atx/avr-mqtt-board/README.md

avr-mqtt-board
==============

Board with AVR and Ethernet supporting MQTT
