atx/avr-mqtt-board/enclosure.dxf

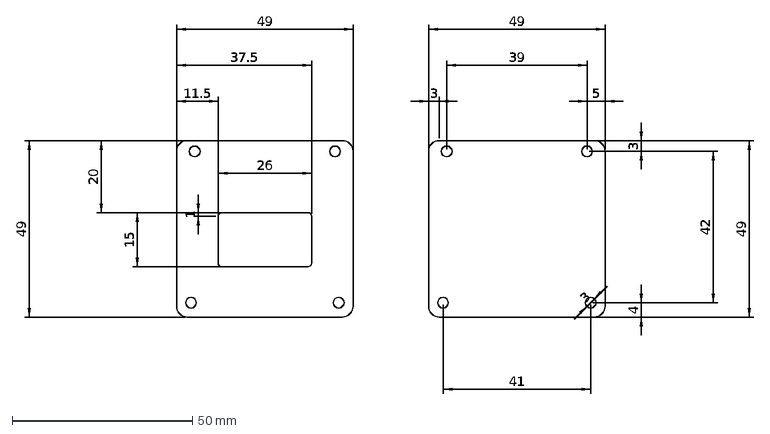
[picture p1: CAD file, 2014-08-16]
enclosure.dxf
39
49
3
5
4
42
41
37.5
11.5
26
15
1
20
