atx/avr-mqtt-board/pcb/avr-sensors.pdf

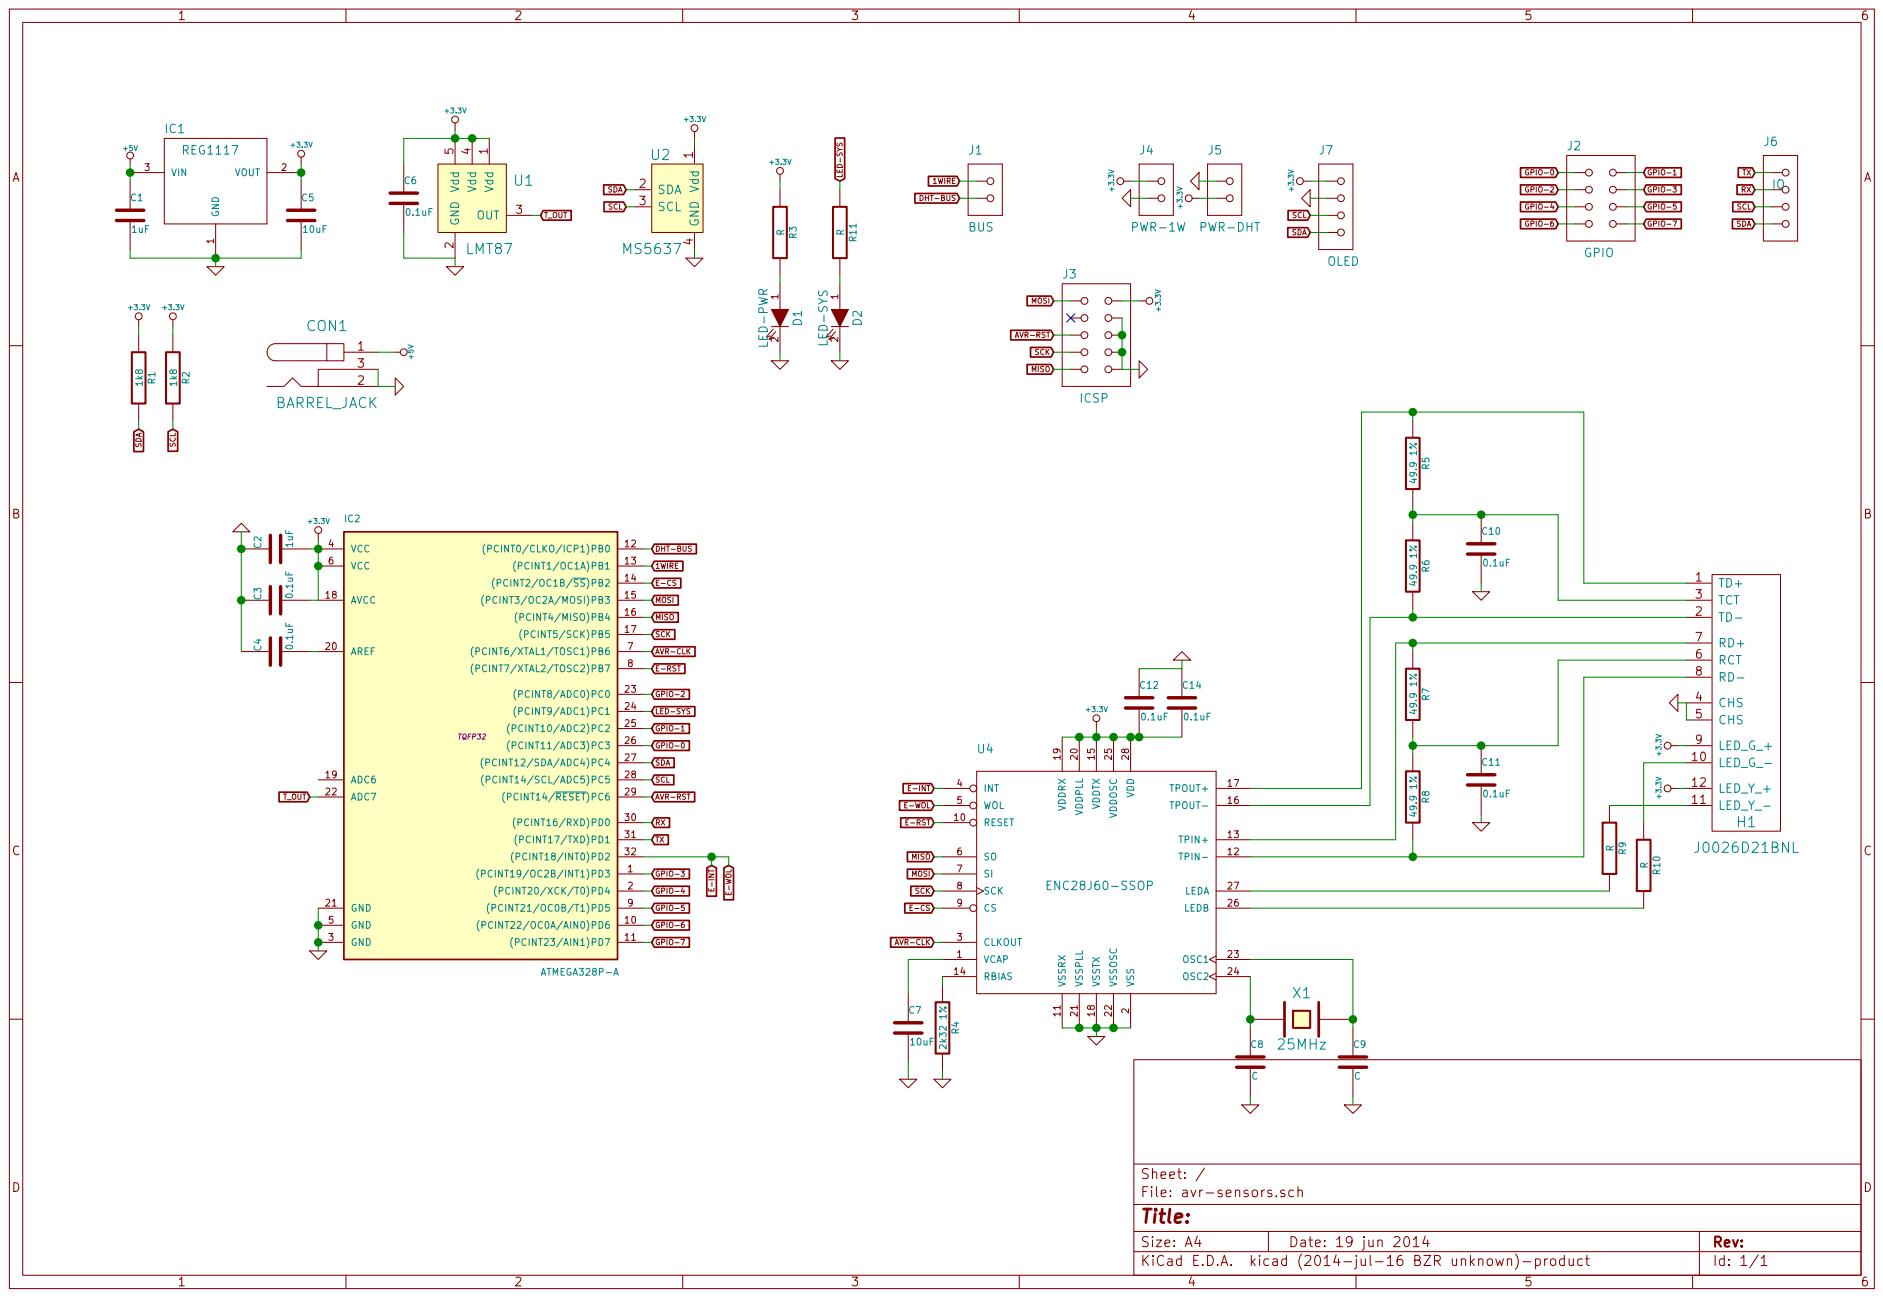
[picture p2: page 1]

E-INT E-WOL MISO MOSI SCK

+3.3V GPIO-2 GPIO-3 GPIO-4 GPIO-5 GPIO-6 GPIO-7

Id: 1/1 Title: File: avr-sensors.sch Sheet: /
