atx/avr-mqtt-board/pcb/avr-sensors.kicad_pcb

## KiCad design pcb/avr-sensors.kicad_pcb (2014-08-08)

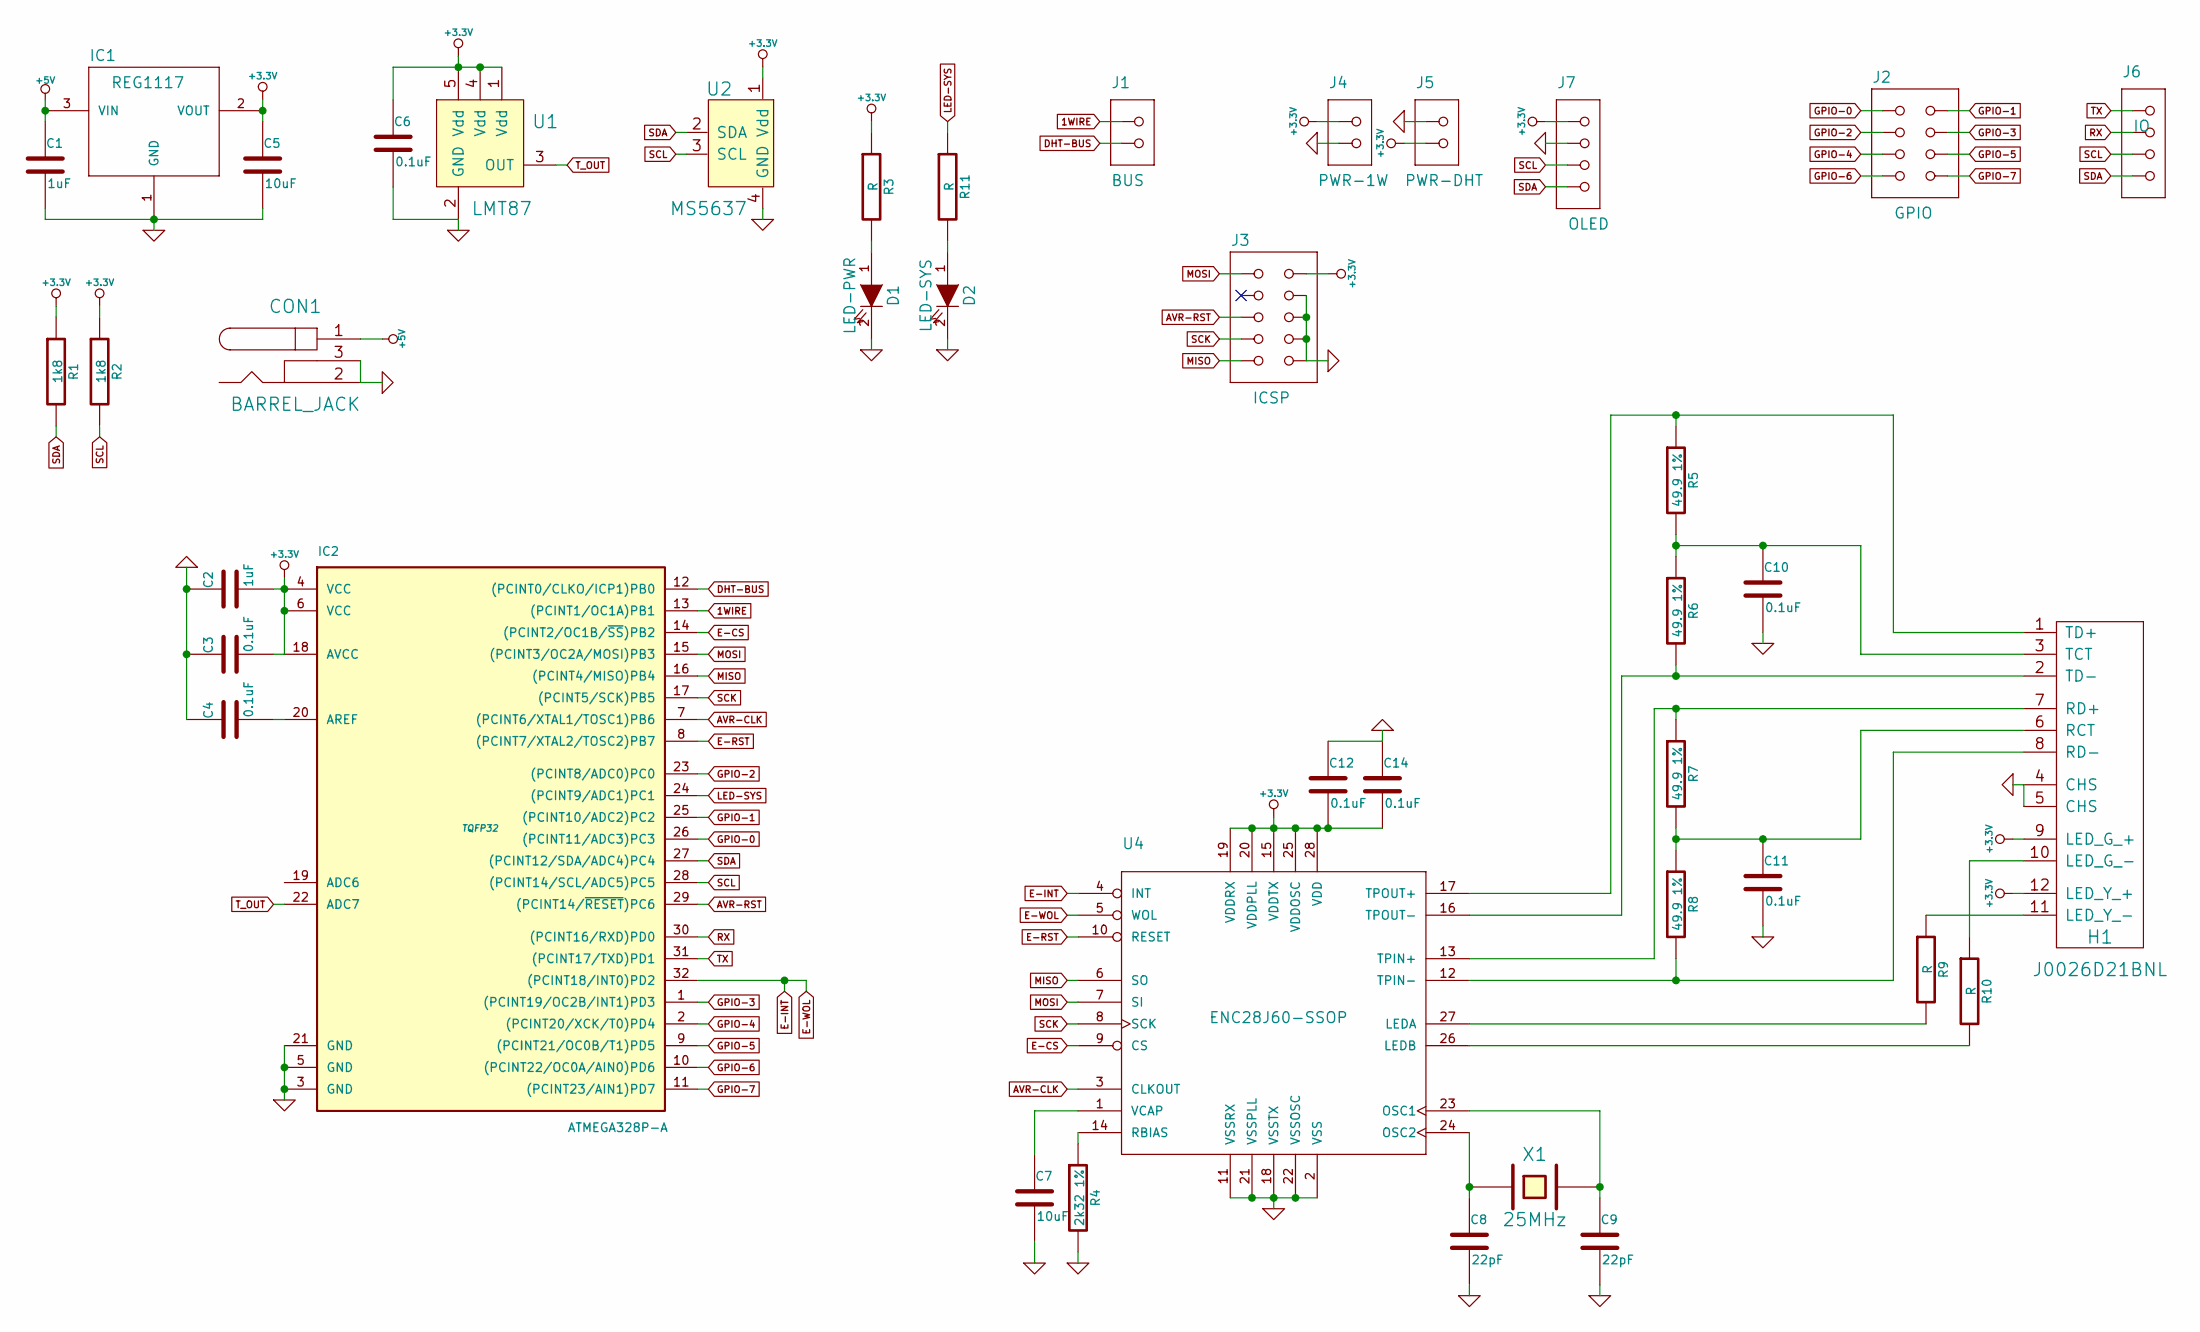
[picture p3: schematic avr-sensors.sch]

Parts:
C1, C2: 1uF
C3, C4, C6, C10, C11, C12, C14: 0.1uF
C5, C7: 10uF
C8, C9: 22pF
CON1: BARREL_JACK
D1: LED-PWR
D2: LED-SYS
H1: J0026D21BNL
IC1: REG1117; burr-brown-3-SOT223
IC2: ATMEGA328P-A; TQFP32
J1: BUS; dp_devices-TERMINAL_BLOCK_2P_5
J2: GPIO; dp_devices-M2X4
J3: ICSP; dp_devices-M2X5
J4: PWR-1W; dp_devices-TERMINAL_BLOCK_2P_5
J5: PWR-DHT; dp_devices-TERMINAL_BLOCK_2P_5
J6: IO; dp_devices-M1X4
J7: OLED; dp_devices-M1X4
R1, R2: 1k8
R3, R9, R10, R11: R
R4: 2k32 1%
R5, R6, R7, R8: 49.9 1%
U1: LMT87
U2: MS5637
U4: ENC28J60-SSOP; microchip-enc28j60-SSOP28
X1: 25MHz

Connections:
1WIRE: IC2.13 ((PCINT1/OC1A)PB1), J1.1
+3.3V: C2.2, C3.2, C5.1, C6.1, C12.2, C14.2, H1.9 (LED_G_+), H1.12 (LED_Y_+), IC1.2 (VOUT), IC2.4 (VCC), IC2.6 (VCC), IC2.18 (AVCC), J3.2, J4.1, J5.2, J7.1, R1.1, R2.1, R3.1, U1.1 (Vdd), U1.4 (Vdd), U1.5 (Vdd), U2.1 (Vdd), U4.15 (VDDTX), U4.19 (VDDRX), U4.20 (VDDPLL), U4.25 (VDDOSC), U4.28 (VDD)
+5V: C1.1, CON1.1, IC1.3 (VIN)
AVR-CLK: IC2.7 ((PCINT6/XTAL1/TOSC1)PB6), U4.3 (CLKOUT)
AVR-RST: IC2.29 ((PCINT14/~RESET~)PC6), J3.5
DHT-BUS: IC2.12 ((PCINT0/CLKO/ICP1)PB0), J1.2
E-CS: IC2.14 ((PCINT2/OC1B/~SS~)PB2), U4.9 (CS)
E-INT: IC2.32 ((PCINT18/INT0)PD2), U4.4 (INT), U4.5 (WOL)
E-RST: IC2.8 ((PCINT7/XTAL2/TOSC2)PB7), U4.10 (RESET)
GND: C1.2, C2.1, C3.1, C4.1, C5.2, C6.2, C7.2, C8.2, C9.2, C10.2, C11.2, C12.1, C14.1, CON1.2, CON1.3, D1.2 (K), D2.2 (K), H1.4 (CHS), H1.5 (CHS), IC1.1 (GND), IC2.3 (GND), IC2.5 (GND), IC2.21 (GND), J3.4, J3.6, J3.8, J3.10, J4.2, J5.1, J7.2, R4.2, U1.2 (GND), U2.4 (GND), U4.2 (VSS), U4.11 (VSSRX), U4.18 (VSSTX), U4.21 (VSSPLL), U4.22 (VSSOSC)
GPIO-0: IC2.26 ((PCINT11/ADC3)PC3), J2.1
GPIO-1: IC2.25 ((PCINT10/ADC2)PC2), J2.2
GPIO-2: IC2.23 ((PCINT8/ADC0)PC0), J2.3
GPIO-3: IC2.1 ((PCINT19/OC2B/INT1)PD3), J2.4
GPIO-4: IC2.2 ((PCINT20/XCK/T0)PD4), J2.5
GPIO-5: IC2.9 ((PCINT21/OC0B/T1)PD5), J2.6
GPIO-6: IC2.10 ((PCINT22/OC0A/AIN0)PD6), J2.7
GPIO-7: IC2.11 ((PCINT23/AIN1)PD7), J2.8
LED-SYS: IC2.24 ((PCINT9/ADC1)PC1), R11.1
MISO: IC2.16 ((PCINT4/MISO)PB4), J3.9, U4.6 (SO)
MOSI: IC2.15 ((PCINT3/OC2A/MOSI)PB3), J3.1, U4.7 (SI)
unnamed: C4.2, IC2.20 (AREF)
unnamed: C7.1, U4.1 (VCAP)
unnamed: C8.1, U4.24 (OSC2), X1.1
unnamed: C9.1, U4.23 (OSC1), X1.2
unnamed: C10.1, H1.3 (TCT), R5.2, R6.1
unnamed: C11.1, H1.6 (RCT), R7.2, R8.1
unnamed: D1.1 (A), R3.2
unnamed: D2.1 (A), R11.2
unnamed: H1.1 (TD+), R5.1, U4.17 (TPOUT+)
unnamed: H1.2 (TD-), R6.2, U4.16 (TPOUT-)
unnamed: H1.7 (RD+), R7.1, U4.13 (TPIN+)
unnamed: H1.8 (RD-), R8.2, U4.12 (TPIN-)
unnamed: H1.10 (LED_G_-), R10.1
unnamed: H1.11 (LED_Y_-), R9.1
unnamed: R4.1, U4.14 (RBIAS)
unnamed: R9.2, U4.27 (LEDA)
unnamed: R10.2, U4.26 (LEDB)
RX: IC2.30 ((PCINT16/RXD)PD0), J6.2
SCK: IC2.17 ((PCINT5/SCK)PB5), J3.7, U4.8 (SCK)
SCL: IC2.28 ((PCINT14/SCL/ADC5)PC5), J6.3, J7.3, R2.2, U2.3 (SCL)
SDA: IC2.27 ((PCINT12/SDA/ADC4)PC4), J6.4, J7.4, R1.2, U2.2 (SDA)
TX: IC2.31 ((PCINT17/TXD)PD1), J6.1
T_OUT: IC2.22 (ADC7), U1.3 (OUT)

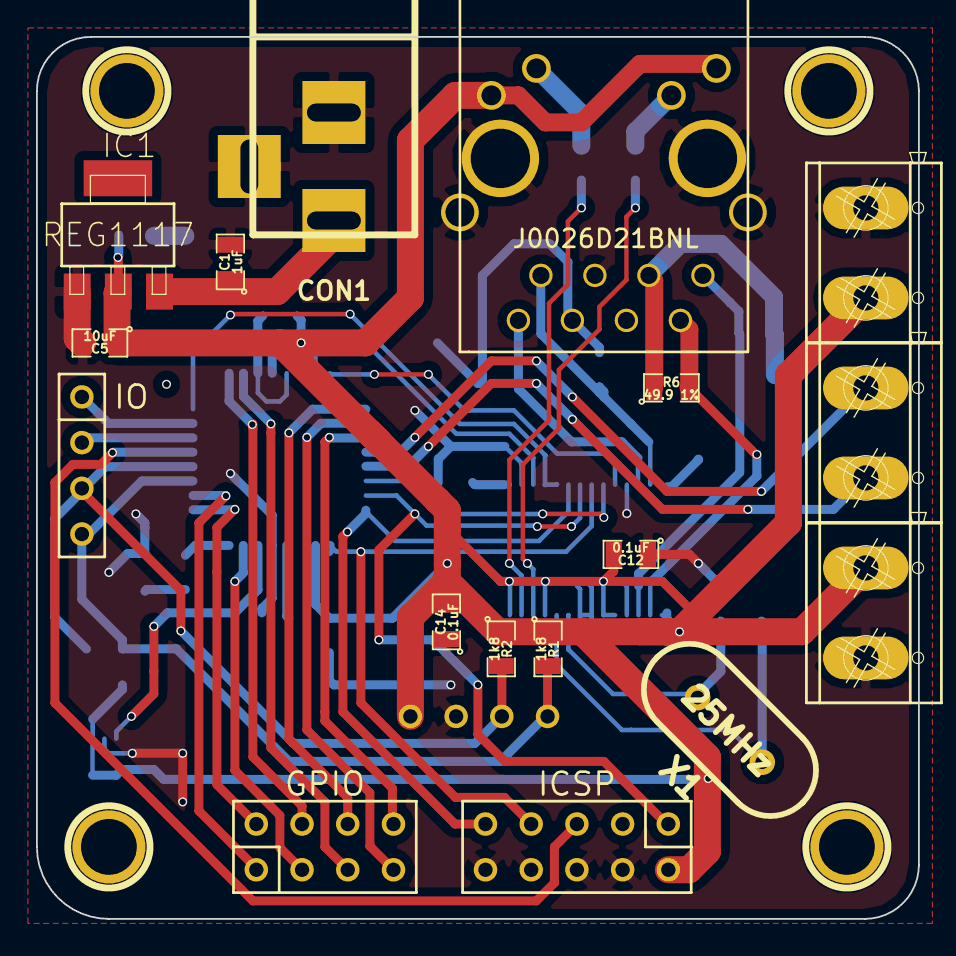
[picture p4: board avr-sensors.kicad_pcb from above]

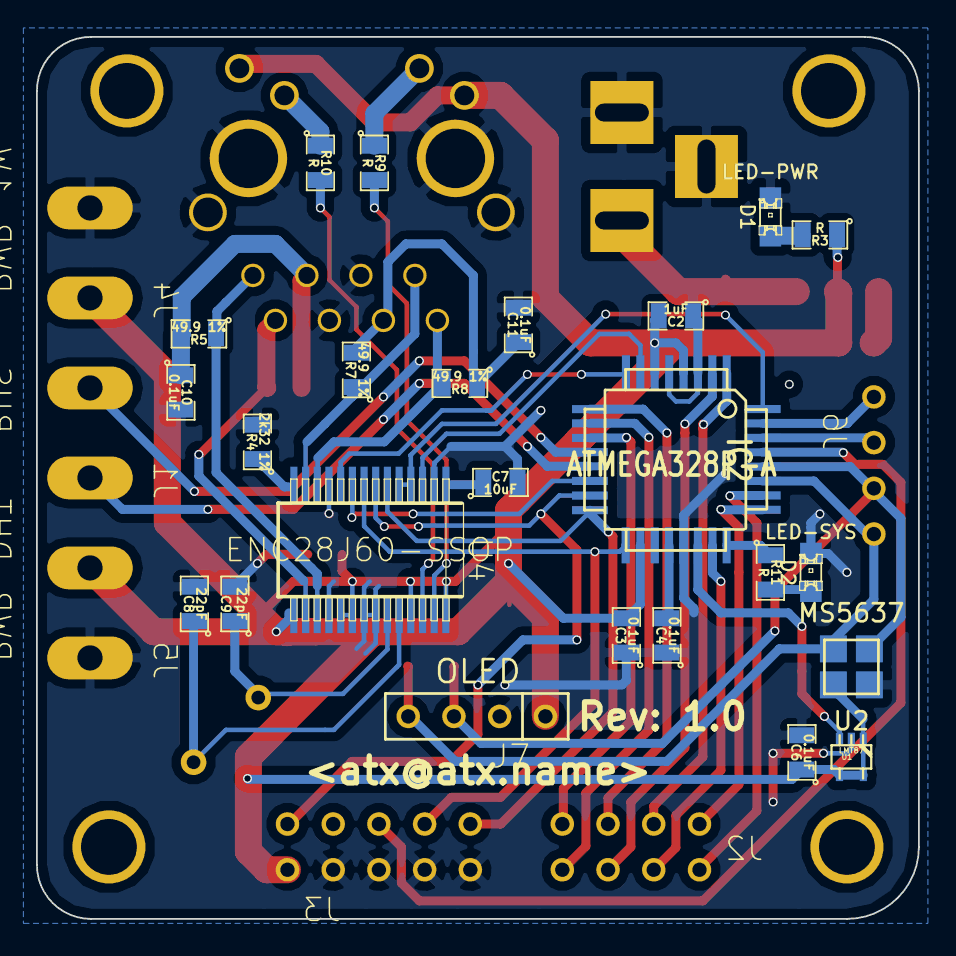
[picture p5: board avr-sensors.kicad_pcb from below]

Board: 2 copper layers, 49.0 x 49.0 mm, 41 parts (24 on the bottom side), 44 nets.
