atx/avr-mqtt-board/src/bitmaps.h

#include <avr/pgmspace.h>

const uint8_t PROGMEM bitmaps_7seg7x16[][14] = {
	{
		0xf0, 0xf0, 0x30, 0x30, 0x30, 0xf0, 0xf0,
		0xff, 0xff, 0xc0, 0xc0, 0xc0, 0xff, 0xff,
	},
	{
		0x00, 0x00, 0x00, 0x00, 0x00, 0xf0, 0xf0,
		0x00, 0x00, 0x00, 0x00, 0x00, 0xff, 0xff,
	},
	{
		0x30, 0x30, 0x30, 0x30, 0x30, 0xf0, 0xf0,
		0xfe, 0xfe, 0xc6, 0xc6, 0xc6, 0xc7, 0xc7,
	},
	{
		0x30, 0x30, 0x30, 0x30, 0x30, 0xf0, 0xf0,
		0xc6, 0xc6, 0xc6, 0xc6, 0xc6, 0xff, 0xff,
	},
	{
		0xf0, 0xf0, 0x00, 0x00, 0x00, 0xf0, 0xf0,
		0x07, 0x07, 0x06, 0x06, 0x06, 0xff, 0xff,
	},
	{
		0xf0, 0xf0, 0x30, 0x30, 0x30, 0x30, 0x30,
		0xc7, 0xc7, 0xc6, 0xc6, 0xc6, 0xfe, 0xfe,
	},
	{
		0xf0, 0xf0, 0x30, 0x30, 0x30, 0x30, 0x30,
		0xff, 0xff, 0xc6, 0xc6, 0xc6, 0xfe, 0xfe,
	},
	{
		0x30, 0x30, 0x30, 0x30, 0x30, 0xf0, 0xf0,
		0x00, 0x00, 0x00, 0x00, 0x00, 0xff, 0xff,
	},
	{
		0xf0, 0xf0, 0x30, 0x30, 0x30, 0xf0, 0xf0,
		0xff, 0xff, 0xc6, 0xc6, 0xc6, 0xff, 0xff,
	},
	{
		0xf0, 0xf0, 0x30, 0x30, 0x30, 0xf0, 0xf0,
		0xc7, 0xc7, 0xc6, 0xc6, 0xc6, 0xff, 0xff,
	},
	{
		0x00, 0x00, 0x00, 0x00, 0x80, 0xe0, 0x30,
		0x80, 0xe0, 0x38, 0x0e, 0x03, 0x00, 0x00,
	},
};

const uint8_t PROGMEM bitmaps_percent9x16[] = {
	0xe0, 0xe0, 0x60, 0x60, 0xe0, 0xe0, 0x00, 0x80, 0xc0, 0xe0, 0x60,
	0xcf, 0xef, 0x7c, 0x3c, 0x1f, 0xff, 0xff, 0xc7, 0xc7, 0xfe, 0xfe,
};

const uint8_t PROGMEM bitmaps_7seg12x24[][36] = {
	{
		0xfc, 0xfc, 0x0c, 0x0c, 0x0c, 0x0c, 0x0c, 0x0c, 0x0c, 0x0c, 0xfc, 0xfc,
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
	{0x00, 0x7F, 0x49, 0x49, 0x49, 0x36}, /* B */
	{0x00, 0x3E, 0x41, 0x41, 0x41, 0x22}, /* C */
	{0x00, 0x7F, 0x41, 0x41, 0x22, 0x1C}, /* D */
	{0x00, 0x7F, 0x49, 0x49, 0x49, 0x41}, /* E */
	{0x00, 0x7F, 0x09, 0x09, 0x09, 0x01}, /* F */
	{0x00, 0x3E, 0x41, 0x49, 0x49, 0x7A}, /* G */
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
};
