atx/avr-mqtt-board/src/nethandler.c

/* 
 * This fil handles various network related tasks
 *
 * Copyright (C) Josef Gajdusek <atx@atx.name>
 *
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
 * */

#include <avr/interrupt.h>
#include <string.h>

#include "common.h"
#include "uip.h"
#include "uip_arp.h"
#include "network.h"

#define BUF (((struct uip_eth_hdr *)&uip_buf[0]))
#pragma GCC diagnostic ignored "-Wstrict-aliasing"

void nethandler_rx()
{
	uip_len = network_read();

	if (uip_len > 0) {
		switch (ntohs(BUF->type)) {
		case UIP_ETHTYPE_IP:
			uip_arp_ipin();
			uip_input();
			if (uip_len > 0) {
				uip_arp_out();
				network_send();
			}
		break;
		case UIP_ETHTYPE_ARP:
			uip_arp_arpin();
			if (uip_len > 0)
				network_send();
		break;
		}
	}
}

void nethandler_periodic()
{
	int i;

	times(UIP_CONNS, i) {
		uip_periodic(i);
		if (uip_len > 0) {
			uip_arp_out();
			network_send();
		}
	}
}

void nethandler_periodic_arp()
{
	uip_arp_timer();
}

void nethandler_umqtt_init(struct umqtt_connection *conn)
{
	struct uip_conn *uc;
	uip_ipaddr_t ip;

	uip_ipaddr(&ip, MQTT_IP0, MQTT_IP1, MQTT_IP2, MQTT_IP3);
	uc = uip_connect(&ip, htons(1883));
	if (uc == NULL)
		return;

	umqtt_init(conn);
	umqtt_circ_init(&conn->txbuff);
	umqtt_circ_init(&conn->rxbuff);

	umqtt_connect(conn, MQTT_KEEP_ALIVE, MQTT_CLIENT_ID);

	uc->appstate.conn = conn;
}

void nethandler_umqtt_appcall()
{
	struct umqtt_connection *conn = uip_conn->appstate.conn;
	uint8_t buff[uip_mss() > (unsigned int) conn->txbuff.datalen ?
		(unsigned int) conn->txbuff.datalen : uip_mss()];
	int ret;

	if (uip_newdata()) {
		umqtt_circ_push(&conn->rxbuff, uip_appdata, uip_datalen());
		umqtt_process(conn);
	}

	if (uip_poll() || uip_acked()) {
		ret = umqtt_circ_pop(&conn->txbuff, buff, sizeof(buff));
		if (!ret)
			return;
		uip_send(buff, ret);
	}
}
