atx/avr-mqtt-board/(commit log)

2014-08-05 pcb: Added the pcb files
    [avr-sensors.kicad_pcb, avr-sensors.sch]
2014-08-05 pcb: Fixed wrong value of the Ethernet termination resistors
    Value was 49k9, corrected to 49.9
    [avr-sensors.sch]
2014-08-05 src: Added sensors_send()
    The sensors_send (and the sensors_send_* macros) contain common code which was
    previously duplicated in the main function.
2014-08-05 src: Make the temperature and humidity sensors optional
    By defining HAS_DHT and/or HAS_DS in the config.h file, the firmware can be now
    compiled without support for any of these sensors. This also stops posting the
    sensor information to the corresponding MQTT topic.
2014-08-05 src: Added support for button inputs
    This feature allows us to watch for falling edge on defined GPIO pins and report
    this to the MQTT broker. The GPIO lines are software debounced and have the
    internall pullups activated on startup.
    [config.h, main.c]
2014-08-05 src/main.c: Changed structure of sensor handling functions
    This commit splits most of the sensor handling code to separate functions. This
    makes the #ifdef-ed parts of the main function slightly more readable.
2014-08-05 src/main.c: Switched to timer_tryrestart where applicable
2014-08-06 src: Made sensor publish and display rate configurable
    The symbols SENSORS_PUBLISH_RATE and SENSORS_DISPLAY_RATE can be used to
    set the rate at which data from sensors is published and refreshed on the
    display.
2014-08-06 pcb: Fix some pads being only on one side of the PCB
    Pads on the screw terminals and 2.54mm headers were only on one side of the
    PCB.
    [avr-sensors.kicad_pcb]
2014-08-06 pcb: Changed wrong resistor value
    Value of the Ethernet termination resistors used was 49k9 instead of 49.9.
    [avr-sensors.kicad_pcb, avr-sensors.sch]
2014-08-06 pcb: Added schematic in PDF format
    Plotted schematic in eeschema to PDF.
2014-08-08 pcb: Changed the value of crystal capacitors to 22pF
    Changed the previously undefined value of the two capacitors connected to the
    25MHz crystal to 22pF.
    [avr-sensors.kicad_pcb, avr-sensors.sch]
2014-08-16 enclosure: Add the enclosure DXF file
    Added the .dxf file used to make the enclosure.
    [enclosure.dxf]
